dgfiloso/SensorGlove/README.md

# SensorGlove

## Introducción
SensorGlove es un proyecto realizado por 6 alumnos de la Escuela Técnica Superior de Ingenieros de Telecomunicación, Universidad Politécnica de Madrid, para la asignatura Electrónica de Consumo. Este proyecto consiste en realizar el desarrollo completo de un producto para llevarlo al mercado, siguiendo etapas como la realización de un prototipo, la búsqueda de proveedores y fabricantes, el diseño del producto final y la comercialización y difusión del producto.

## Producto
SensorGlove surge como una idea de reinventar el modelismo y conseguir una mayor inmersión del conductor en el dispositivo radiocontrol. Nuestro equipo ha desarrollado un guante autónomo capaz de detectar los movimientos de una mano y enviar los datos de manera inalámbrica. Una de las últimas tendencias tecnológicas y que cada vez se encuentra más presente en nuestro día a día es la realidad virtual, y creemos que nuestro producto es un complemento perfecto para esta tecnología del futuro.

Sin embargo, una de las ventajas de nuestro producto es que tiene una infinidad de aplicaciones, y aunque en este proyecto su propósito sea el modelismo, en un futuro queremos abrir el proyecto a nuevos sectores.

## Prototipo
El prototipo se encuentra dividido en dos partes claramente diferenciadas, el guante y el coche radiocontrol. Ambos partes se han desarrollado usando la placa de desarrollo Arduino Nano, con lo que hemos conseguido un rápido prototipado para ver si nuestro proyecto era viable y poder probar de una manera sencilla los diferentes módulos que usaremos en nuestro producto final.

El guante utiliza tres módulos principales:
+	MPU6050 : Acelerómetro-giróscopo de 6 ejes con el que medimos el ángulo con respecto al eje X y al eje Y.
+	Flex Sensor : Sensor desarrollado por Sparkfun. Se trata de una resistencia que varía su valor en función de cuanto se dobla.
+	NRF24L01 : Transceptor radio que funciona a 2,4 GHz con el que transmitimos los datos.

El coche utiliza dos módulos:
+	NRF24L01 : Transceptor radio que funciona a 2,4 GHz con el recibir los datos del guante.
+	Etapa de potencia: Utilizada para mover los motores del coche radiocontrol.

## Difusión
Para dar a conocer nuestro producto contamos con la página web oficial del proyecto:
+	https://sensorglove.wixsite.com/sensorglove

Además contamos con distintas redes sociales:
+	[Facebook](https://www.facebook.com/Sensor-Glove-428774670806512/)
+	[Twitter](https://twitter.com/sensorglove)
+	[YouTube](https://www.youtube.com/channel/UCL0-cJEzkYREWF3CBP17AOg)

## Equipo
+ Diego Poderoso
+ Laura del Rio
+ Ana Pereira
+ Rodrigo Morrás
+ Daniel Fortún 
+ David González Filoso
