dgfiloso/SensorGlove/PCB/Guante/sensor_glove.brd

## EAGLE design PCB/Guante/sensor_glove.brd (2017-05-10)

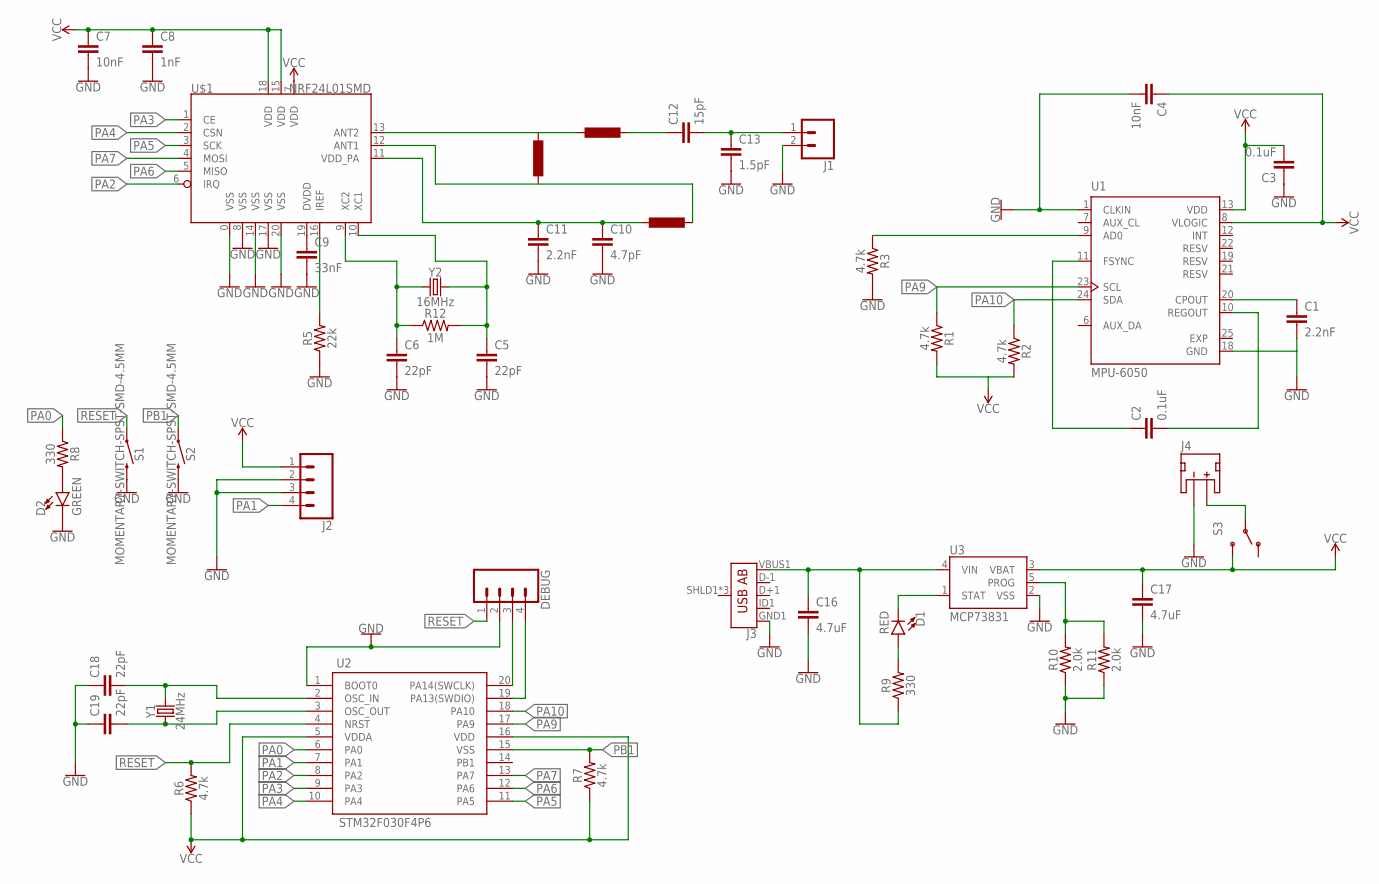
[picture p1: schematic sensor_glove.sch]

Parts:
C1, C11: 2.2nF; 0603
C2, C3: 0.1uF; 0402
C4, C7: 10nF; 0603
C5, C6, C18, C19: 22pF; 0603
C8: 1nF; 0603
C9: 33nF; 0603
C10: 4.7pF; 0603
C12: 15pF; 0402
C13: 1.5pF; 0603
C16, C17: 4.7uF; 0603
D1: RED; LED-0603
D2: GREEN; LED-0603
DEBUG: CONN_04; 1X04
J1: CONN_02; 1X02
J2: CONN_04; 1X04
J3: USB_AB_SMT; USB-AB-MICRO-SMD
J4: JST_2MM_MALE; JST-2-SMD
R1, R2, R3, R6, R7: 4.7k; 0603
R5: 22k; 0603
R8, R9: 330; 0603
R10, R11: 2.0k; 0603
R12: 1M; 0603
S1, S2: MOMENTARY-SWITCH-SPST-SMD-4.5MM; TACTILE_SWITCH_SMD_4.5MM
S3: SWITCH-SPDTSMD; SWITCH_SPDT_SMD
U1: MPU-6050; QFN50P400X400X95-25N
U2: STM32F030F4P6; TSSOP20-STM32
U3: MCP73831; SOT23-5
U$1: NRF24L01SMD; QFN20-4X4MM
Y1: 24MHz; CRYSTAL-SMD-5X3.2-4PAD
Y2: 16MHz; HC49US

Connections:
CON: J4.2 (+), S3.2
EXP: U1.25 (EXP)
FSYNC: C2.1, U1.11 (FSYNC)
GND: C3.1, C4.2, C5.2, C6.2, C7.2, C8.2, C9.2, C10.2, C11.2, C13.2, C16.2, C17.2, C18.1, C19.1, D2.C, DEBUG.2, J1.2, J2.2, J2.3, J3.GND1 (GND), J4.1 (-), R3.2, R5.1, S1.1 (2), S1.4 (2), S2.1 (2), S2.4 (2), U1.1 (CLKIN), U2.1 (BOOT0), U$1.0 (VSS), U$1.8 (VSS), U$1.14 (VSS), U$1.17 (VSS), U$1.20 (VSS)
unnamed: R3.1, U1.9 (AD0)
unnamed: C16.1, J3.VBUS1 (VBUS), R9.1, U3.4 (VIN)
unnamed: DEBUG.3, U2.20 (PA14(SWCLK))
unnamed: C6.1, R12.1, U$1.9 (XC2), Y2.1
unnamed: C1.1, U1.20 (CPOUT)
unnamed: C1.2, U1.18 (GND)
unnamed: C5.1, R12.2, U$1.10 (XC1), Y2.2
unnamed: C10.1, C11.1, U$1.11 (VDD_PA)
unnamed: C9.1, U$1.19 (DVDD)
unnamed: R5.2, U$1.16 (IREF)
unnamed: C12.2, C13.1, J1.1
unnamed: C18.2, U2.2 (OSC_IN), Y1.3 (2)
unnamed: C19.2, U2.3 (OSC_OUT), Y1.1
unnamed: DEBUG.4, U2.19 (PA13(SWDIO))
unnamed: D2.A, R8.2
unnamed: D1.C, U3.1 (STAT)
unnamed: D1.A, R9.2
unnamed: R10.2, R11.2, U3.5 (PROG)
unnamed: R10.1, R11.1
PA0: R8.1, U2.6 (PA0)
PA1: J2.4, U2.7 (PA1)
PA2: U2.8 (PA2), U$1.6 (IRQ)
PA3: U2.9 (PA3), U$1.1 (CE)
PA4: U2.10 (PA4), U$1.2 (CSN)
PA5: U2.11 (PA5), U$1.3 (SCK)
PA6: U2.12 (PA6), U$1.5 (MISO)
PA7: U2.13 (PA7), U$1.4 (MOSI)
PA9: R1.1, U1.23 (SCL), U2.17 (PA9)
PA10: R2.1, U1.24 (SDA), U2.18 (PA10)
PB1: R7.2, S2.2 (1), S2.3 (1), U2.15 (VSS)
REGOUT: C2.2, U1.10 (REGOUT)
RESET: DEBUG.1, R6.2, S1.2 (1), S1.3 (1), U2.4 (NRST)
VCC: C3.2, C4.1, C7.1, C8.1, C17.1, J2.1, R1.2, R2.2, R6.1, R7.1, S3.3 (S), U1.8 (VLOGIC), U1.13 (VDD), U2.5 (VDDA), U2.16 (VDD), U3.3 (VBAT), U$1.7 (VDD), U$1.15 (VDD), U$1.18 (VDD)

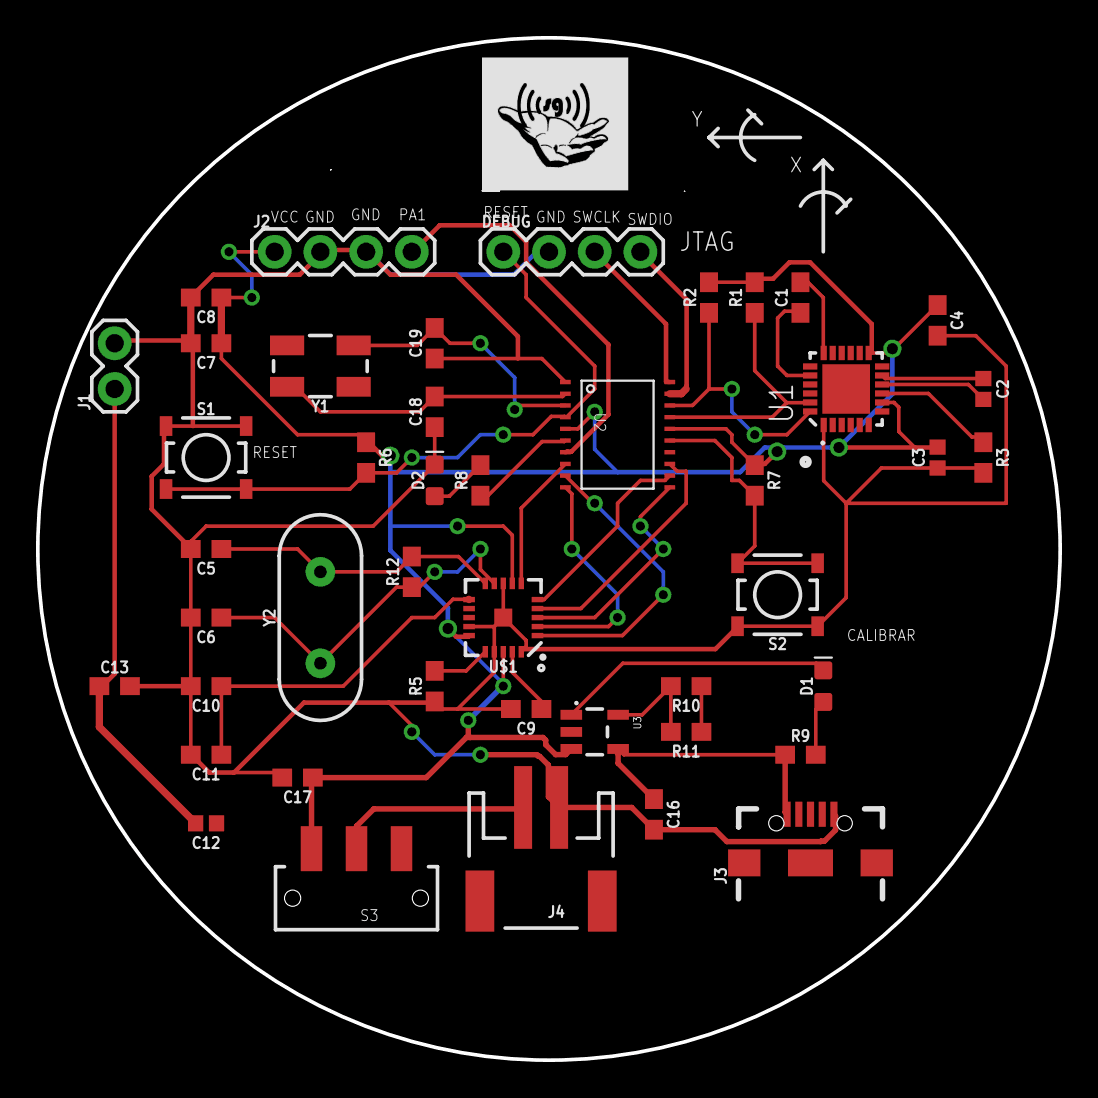
[picture p2: board sensor_glove.brd from above]

Board: 2 copper layers, 56.8 x 56.8 mm, 44 parts (0 on the bottom side), 36 nets.
