dgfiloso/SensorGlove/(commit log)

2017-04-06 Creado proyecto Se ha implementado la recepción de datos del MPU9250 aunque continua fallando
    [empty.cfg, m3_Hwi_asm.obj, m3_Hwi_asm_switch.obj, m3_IntrinsicsSupport_asm.obj, m3_TaskSupport_asm.obj, rom_sysbios.obj]
2017-04-07 Organización en carpetas para los dos módulos del proyecto
    [empty.cfg, m3_Hwi_asm.obj, m3_Hwi_asm_switch.obj, m3_IntrinsicsSupport_asm.obj, m3_TaskSupport_asm.obj, rom_sysbios.obj]
2017-04-07 Carpeta para el receptor
2017-04-19 Sensado Problemas con el I2C, error de bus ocupado.
    [m3_Hwi_asm.obj, m3_Hwi_asm_switch.obj, m3_IntrinsicsSupport_asm.obj, m3_TaskSupport_asm.obj, rom_sysbios.obj]
2017-04-21 Por problemas con el hardware del SensorTag y de tiempo, hemos migrado el proyecto a una plataforma Arduino.
    [empty.cfg, m3_Hwi_asm.obj, m3_Hwi_asm_switch.obj, m3_IntrinsicsSupport_asm.obj, m3_TaskSupport_asm.obj, rom_sysbios.obj]
2017-04-22 Borrado fichero de Readme Texas
2017-05-03 Código implementado completamente, nos encontramos en periodo de pruebas.
2017-05-03 Pruebas realizadas, todo funcionando. Se ha comentado el calibrado y la impresión por puerto serie de trazas.
2017-05-09 Cambiado valor resistivo del Flex Sensor con un ángulo de 90º
    [Guante.ino]
2017-05-09 Primera versión de la PCB del producto final
    [sensor_glove.brd, sensor_glove.sch]
2017-05-10 Añadido interruptor en la PCB
    [sensor_glove.brd, sensor_glove.sch]
